perseus784/June_Glasses/media_files/june_glasses~1.jpg

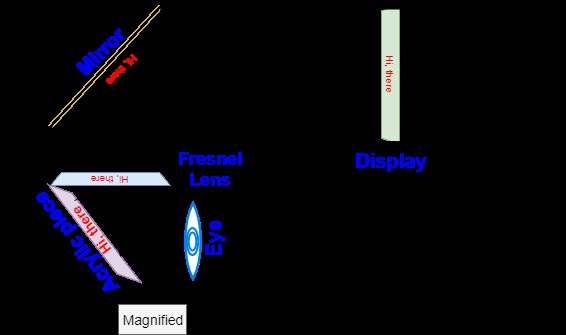
media_files/june_glasses~1.jpg
