perseus784/June_Glasses/media_files/working(4).jpg

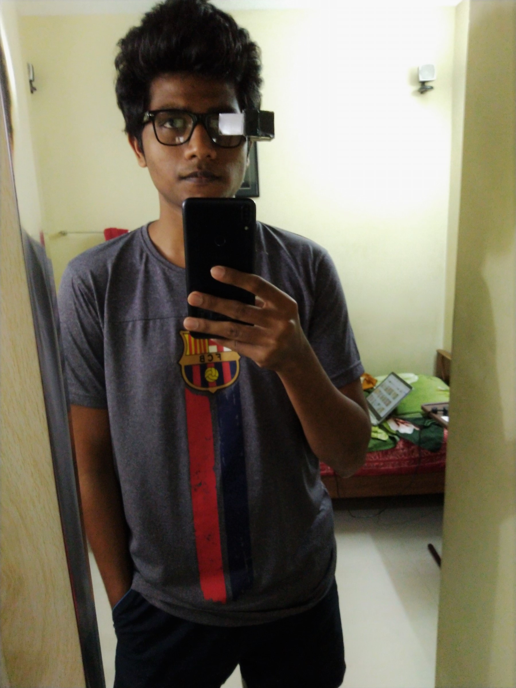
media_files/working(4).jpg
